mascheck55/SensorTester5/LTSPICE/AlbertSpice.asc

C1: cap; 0.047µ; Rser=0.05
C2: cap; 1µ
L1: ind2; 6.8µ; Ipk=1.8 Rser=0.060 Rpar=9724.7 Cpar=4.998p
L2: ind2; 6.8µ
M1: nmos; FDR4420A
M2: pmos; FDR840P
R1: res; 22
R2: res; 10k
R3: res; 10k
R4: res; 10
V1: signal; PULSE(0 5 1.1u 0 0 1u 4u 1)
V2: signal; PULSE(0 4 0 0 0 1u 4u 1)
V3: signal; 5; Rser=0.5
Named nets: 0
.tran 120u
K1 L1 L2 0.03
