mascheck55/SensorTester5/SensorTester5.ino

#include <Arduino.h>

#include "LC_Sensor_Wire.h" //defines if sensor uses I2C
#include "LC_Sensor.h"

LC_Sensor mysensor = LC_Sensor(); // Instance of a sensor
uint8_t v = 0xFF;                 // all inactive
#ifdef LC_SENSOR_USE_WIRE
// ============================================================================
// WIRE CONFIGURATION A4(SDA) A5(SCL) should work like a read only PCF8574
// ============================================================================
#include <Wire.h>
#pragma message "using Wire on A4 and A5 "
#define WIRE Wire
#endif
#ifdef LC_SENSOR_USE_WIRE1
// ============================================================================
// WIRE CONFIGURATION 23(SDA) 24(SCL) should work like a read only PCF8574
// ============================================================================
#include <Wire1.h>
#pragma message "using Wire1 all A0-A7 are available"
#define WIRE Wire1
#endif
// ============================================================================
#if defined(LC_SENSOR_USE_WIRE) || defined(LC_SENSOR_USE_WIRE1)
#define I2C_ADDRESS 0x65
void requestEvent() { WIRE.write(v); }
void receiveEvent(int howMany)
{
  while (WIRE.available())
    WIRE.read();
} // drop everything what is comming}
#endif

void setup()
{
  // put your setup code here, to run once:

#if defined(LC_SENSOR_USE_WIRE) || defined(LC_SENSOR_USE_WIRE1)
  WIRE.begin(I2C_ADDRESS);
  WIRE.onRequest(requestEvent);
  WIRE.onReceive(receiveEvent);
#endif
#define TEST 0   // if 2 calibration works on A2
#define MYZERO 0 // if == 0 Autocalibration
  Serial.begin(115200);
  mysensor.begin(0, 100, 0, 0, TEST); // works on A0
  delay(300);
  Serial.print("is Sensor running? ");
  if (mysensor.isRunning())
    Serial.println("yes");
  else
    Serial.println("no");
  if (MYZERO == 0)
  {
    Serial.print("calibrated on A");
    Serial.print(TEST);
    Serial.print(" with ");
    Serial.print(mysensor.zero(TEST));
    Serial.println(" zero counts");
  }
  else
  {
    Serial.print("Fix calibration with MYZERO");
    Serial.print(MYZERO);
    Serial.println(" if sensors permanent active ");
    Serial.println(" your MYZERO might be to high ");
  }
}

void loop()
{
  // put your main code here, to run repeatedly:
  v = mysensor.virtPort();
  if (v != 0xFF) // Logic is like PCF8574 invers
  {
    Serial.print("0x");
    Serial.print(v, HEX);
    Serial.print("  ");

    for (int i = 7; i >= 0; i--)
    {
      Serial.print(bitRead(v, i));
    }

    Serial.println();
    delay(600);
  }
}
