mascheck55/SensorTester5/(commit log)

2026-04-11 Arduino IDE Stucture
2026-04-12 prepare i2c byte
2026-04-13 simple i2c
2026-04-13 proposed i2c doc
2026-04-13 wire1 works
2026-04-17 pragma for warning A4 and A5 used for Wire
